drupi79/Vortex-Gemini-High-Speed-Fan-Curtain/MOSFET Mount.stl

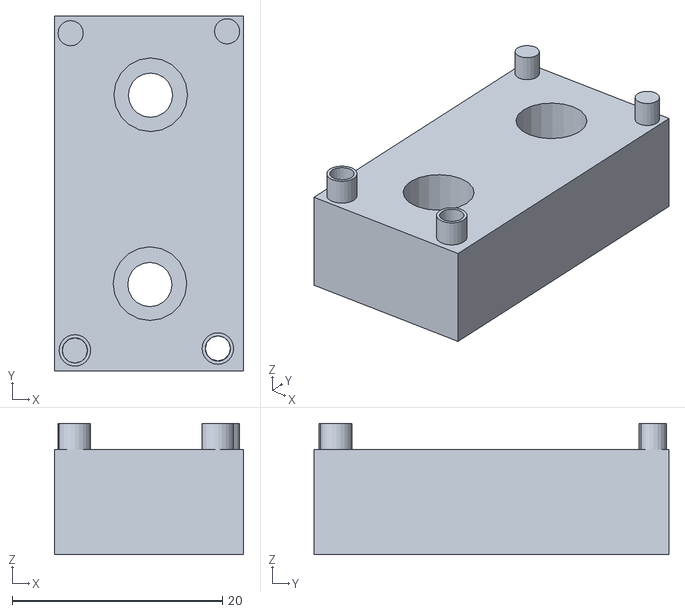
[picture p3: CAD file, 2023-09-23]
MOSFET Mount.stl
18.0 x 33.8 x 12.5
