drupi79/Vortex-Gemini-High-Speed-Fan-Curtain/(commit log)

2023-09-23 Model Files for this mod
    [MOSFET Mount.stl]
2023-09-23 Create Vortex Gemini High Speed Fan Curtain upgrade for the Ender 3 Pro.pdf
